2026-Myongji-Trash-Robot/BLDC_ECU/HW/BLDC_Driver/BLDC_Driver_V1.0_schematic.pdf

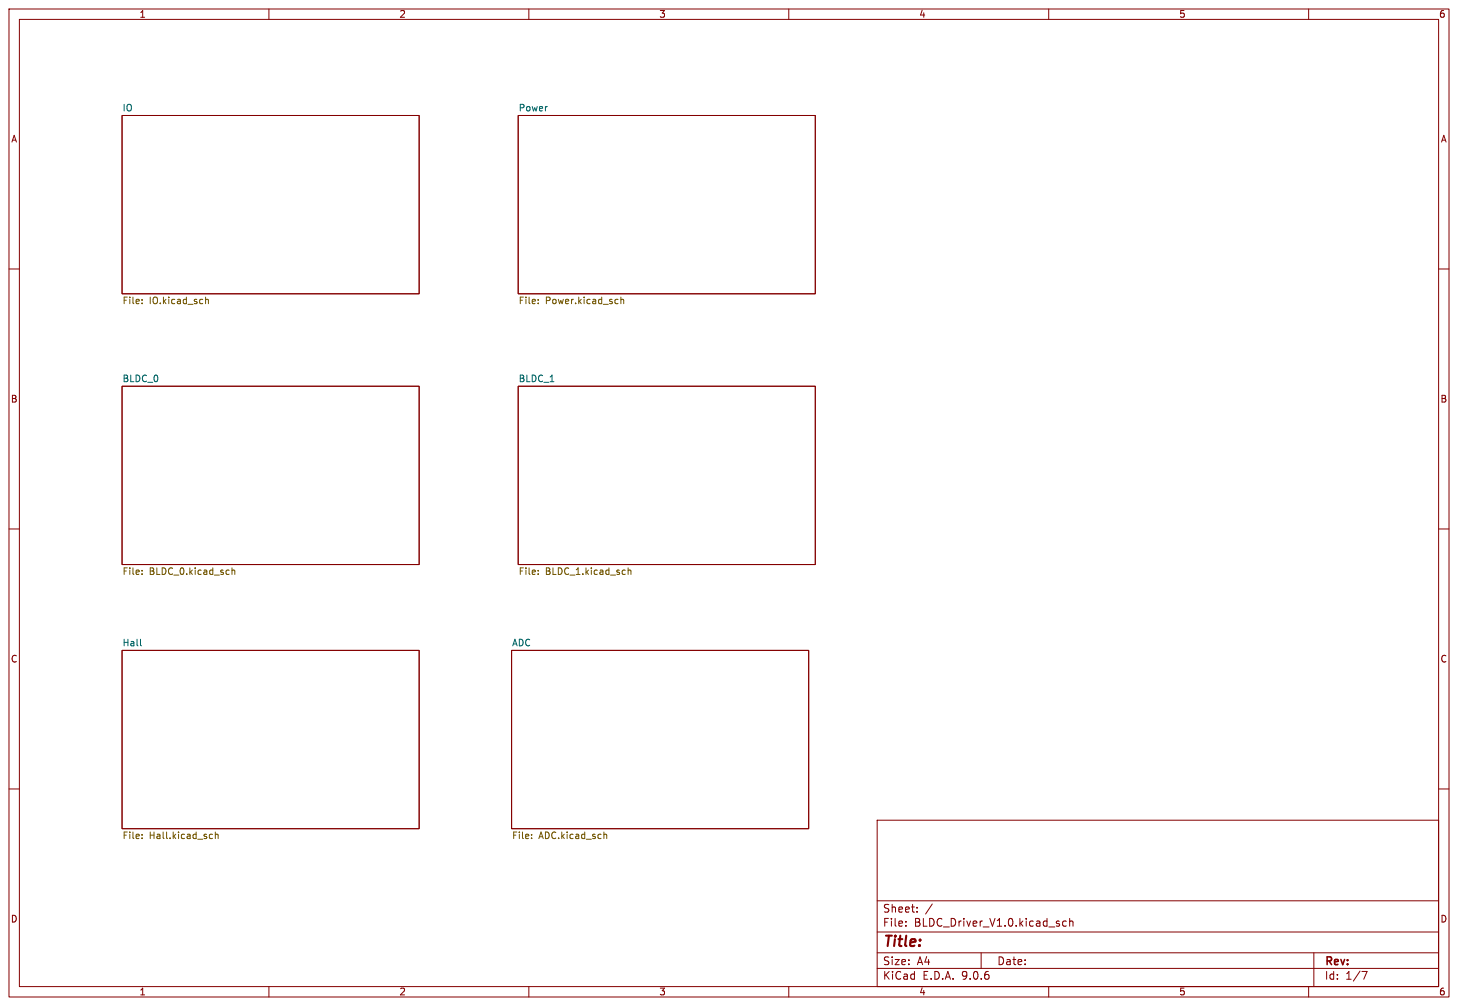
[picture p5: page 1]

Power File: Power.kicad_sch ADC

BLDC_0 File: BLDC_0.kicad_sch Hall File: Hall.kicad_sch

Id: 1/7 Title: File: BLDC_Driver_V1.0.kicad_sch Sheet: /

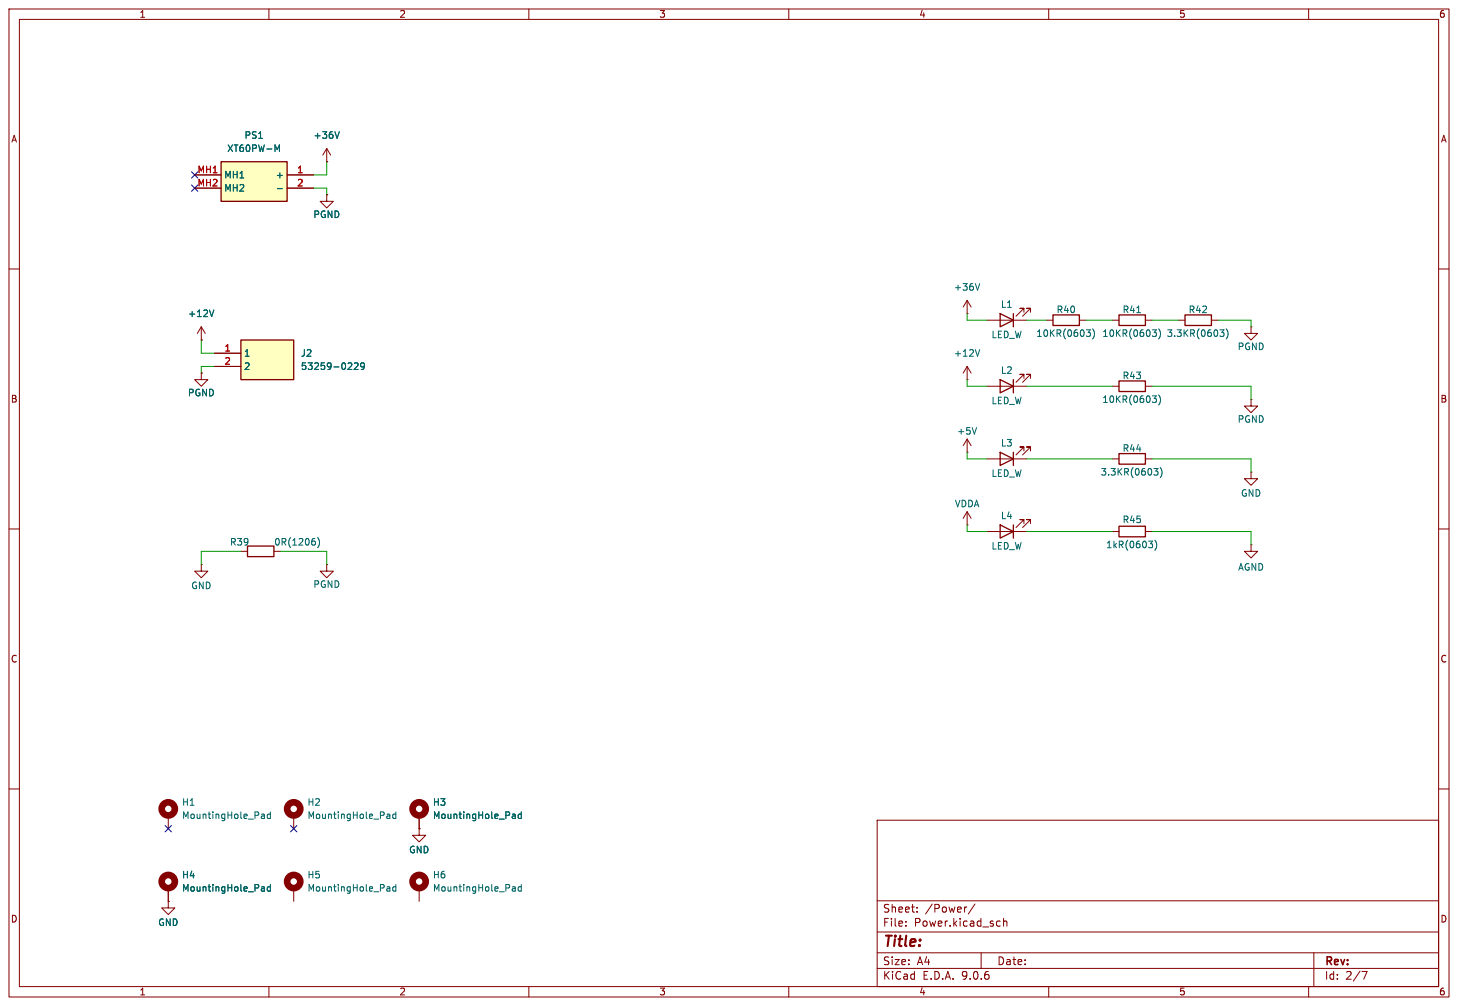
[picture p6: page 2]

Id: 2/7 Title: File: Power.kicad_sch Sheet: /Power/

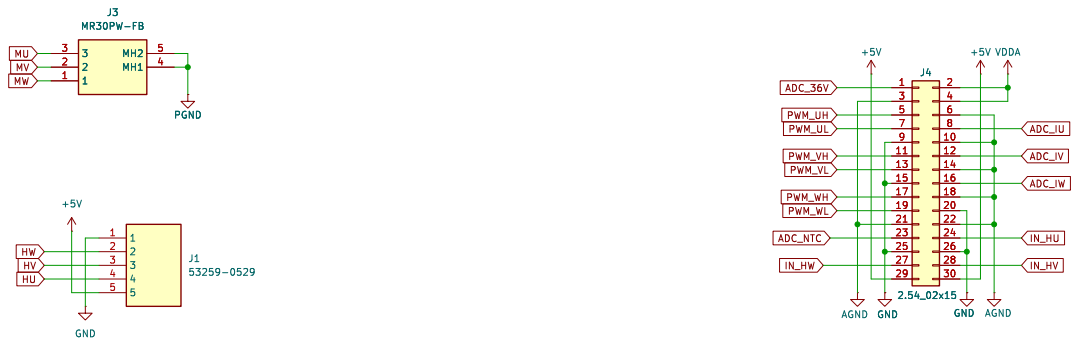
[picture p7: page 3]

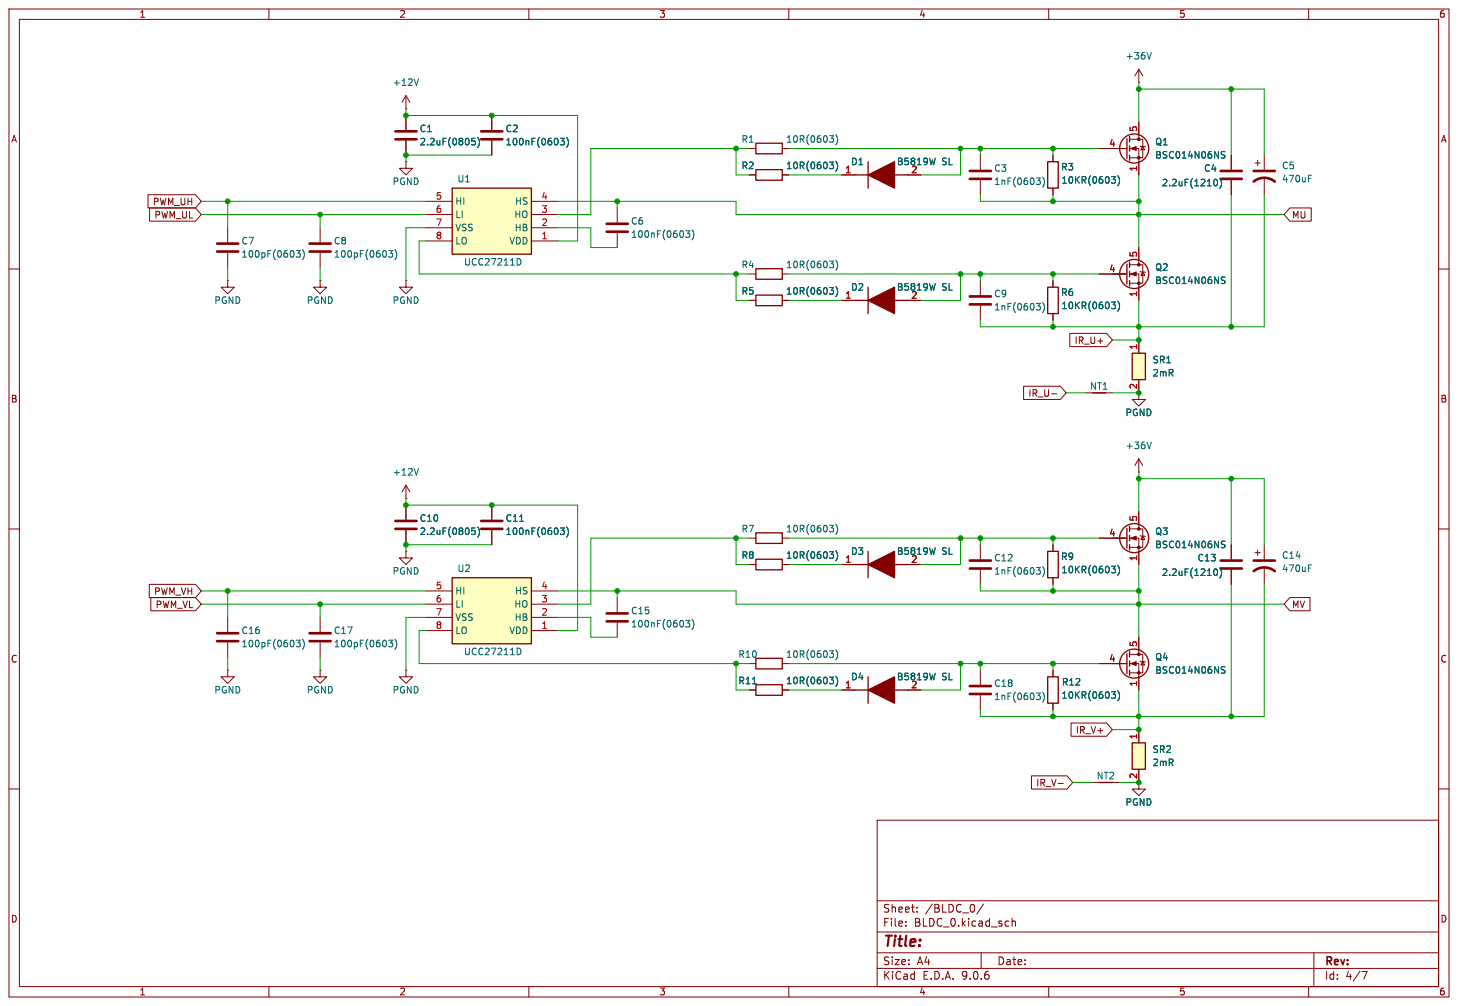
[picture p8: page 4]

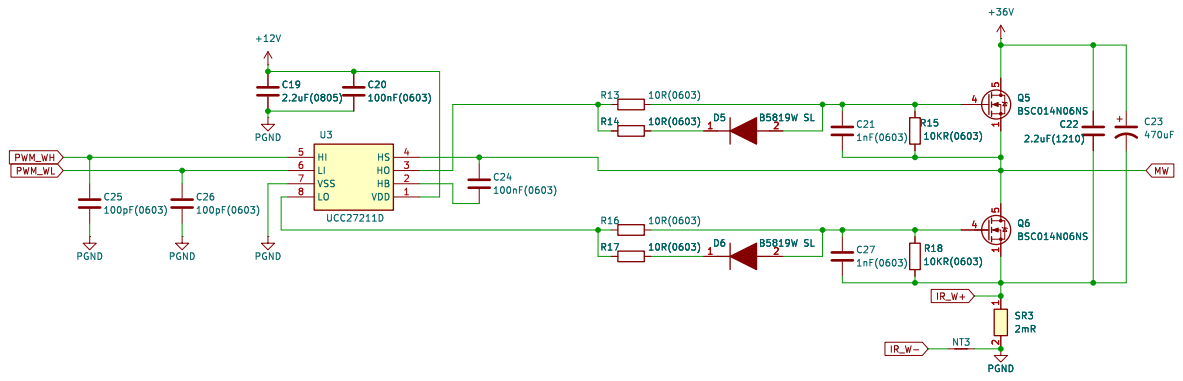
[picture p9: page 5]

Id: 5/7 Title: File: BLDC_1.kicad_sch Sheet: /BLDC_1/

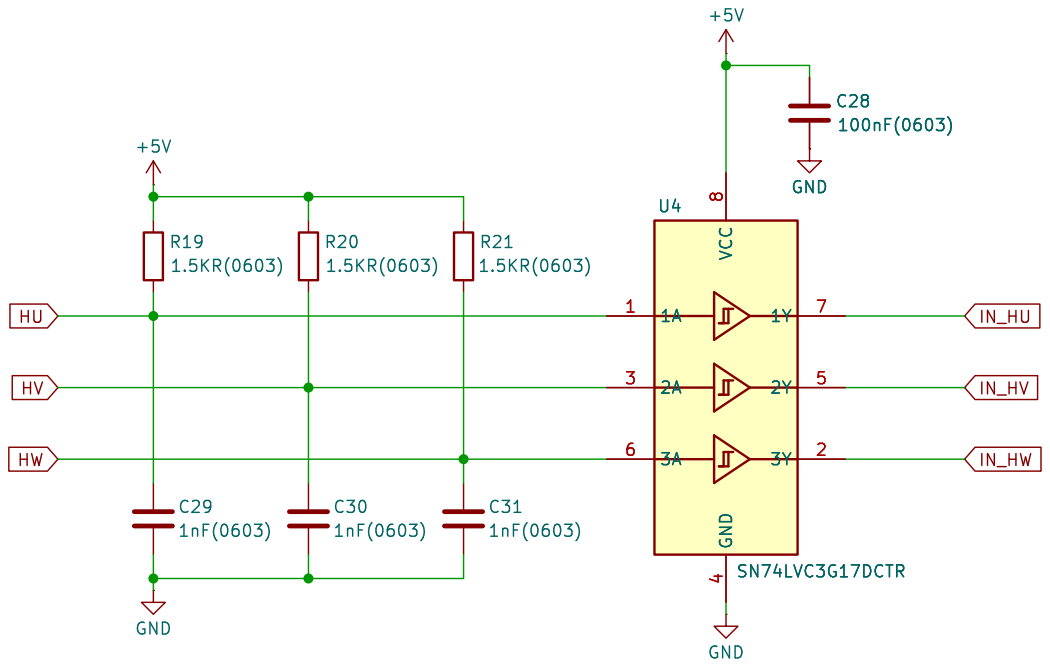
[picture p10: page 6]

Id: 6/7 Title: File: Hall.kicad_sch Sheet: /Hall/

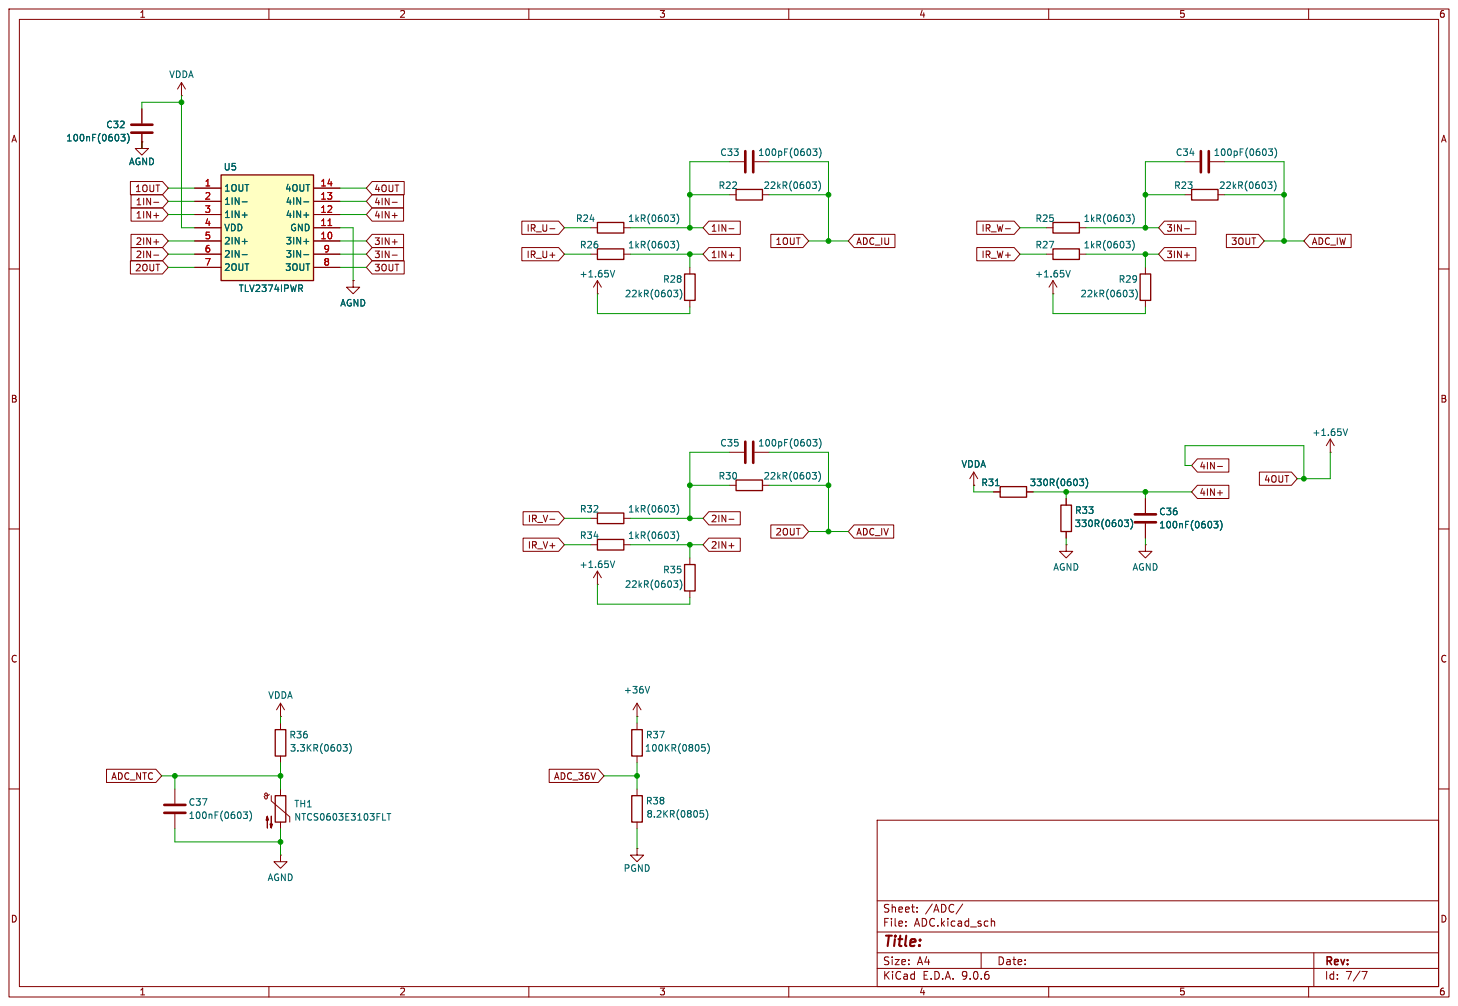
[picture p11: page 7]

Id: 7/7 Title: File: ADC.kicad_sch Sheet: /ADC/
