2026-Myongji-Trash-Robot/BLDC_ECU/HW/BLDC_ECU/BLDC_ECU_V2.0_schematic.pdf

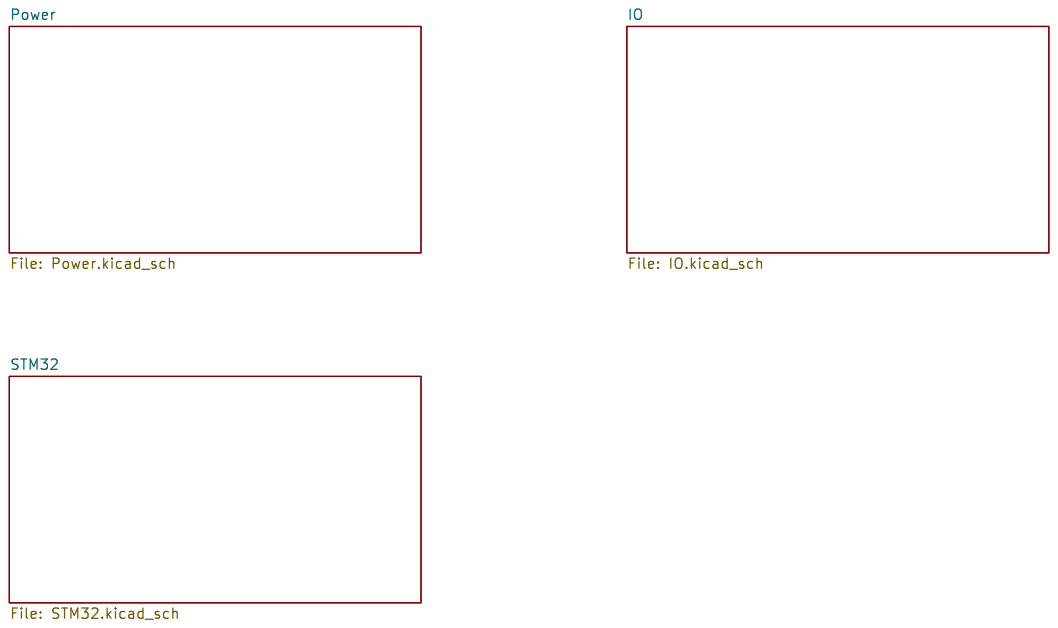
[picture p12: page 1]

Id: 1/4 Title: File: BLDC_ECU_V2.0.kicad_sch Sheet: /

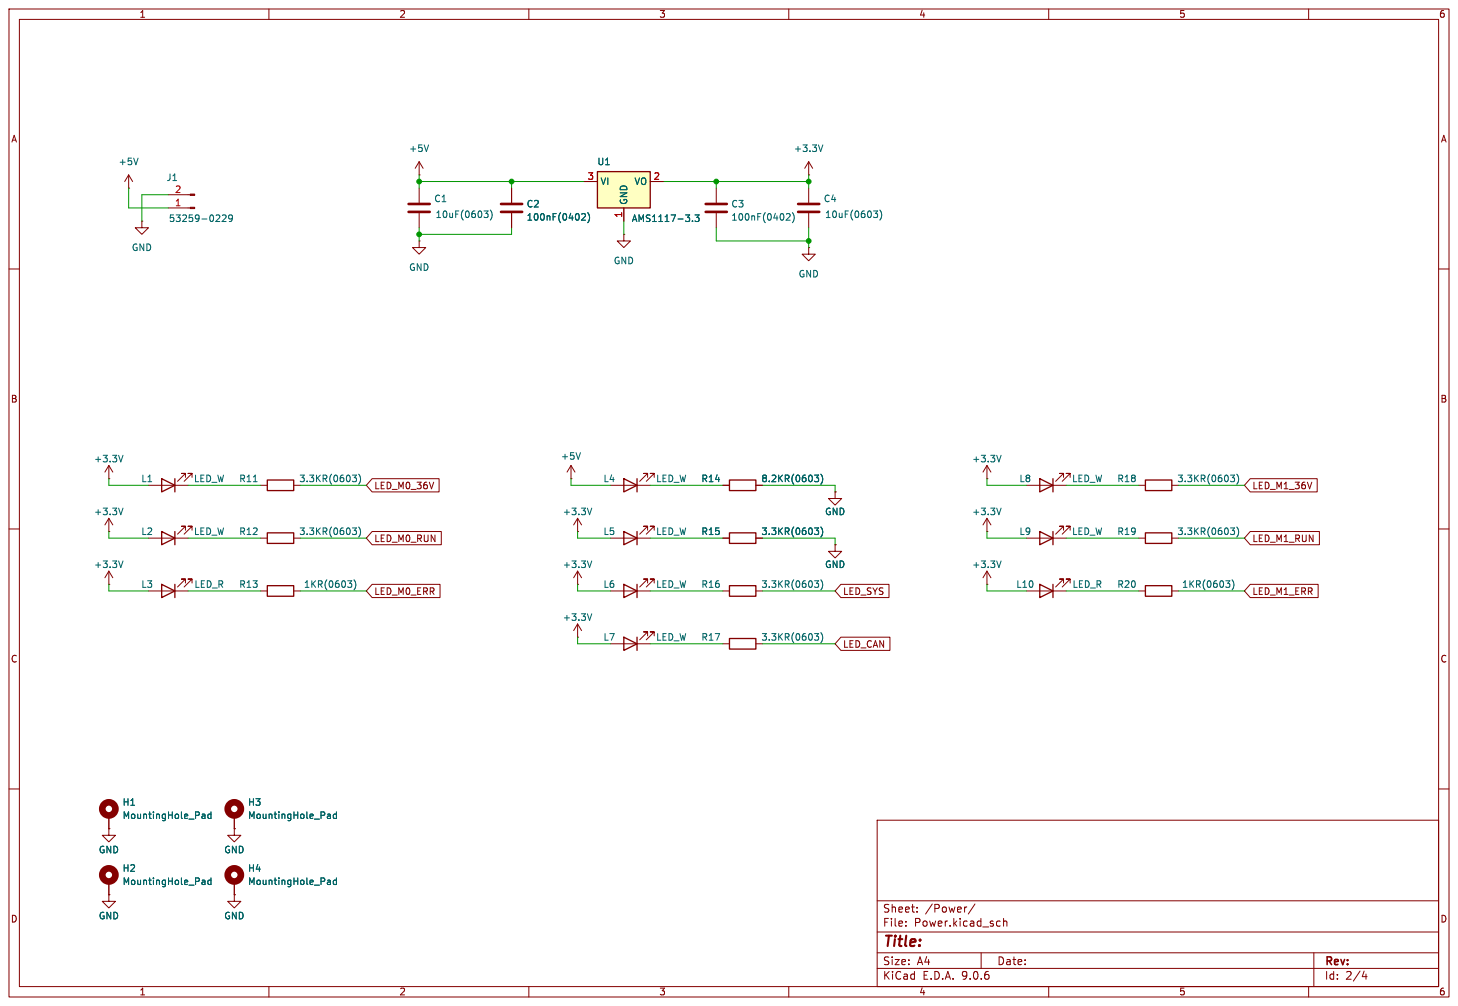
[picture p13: page 2]

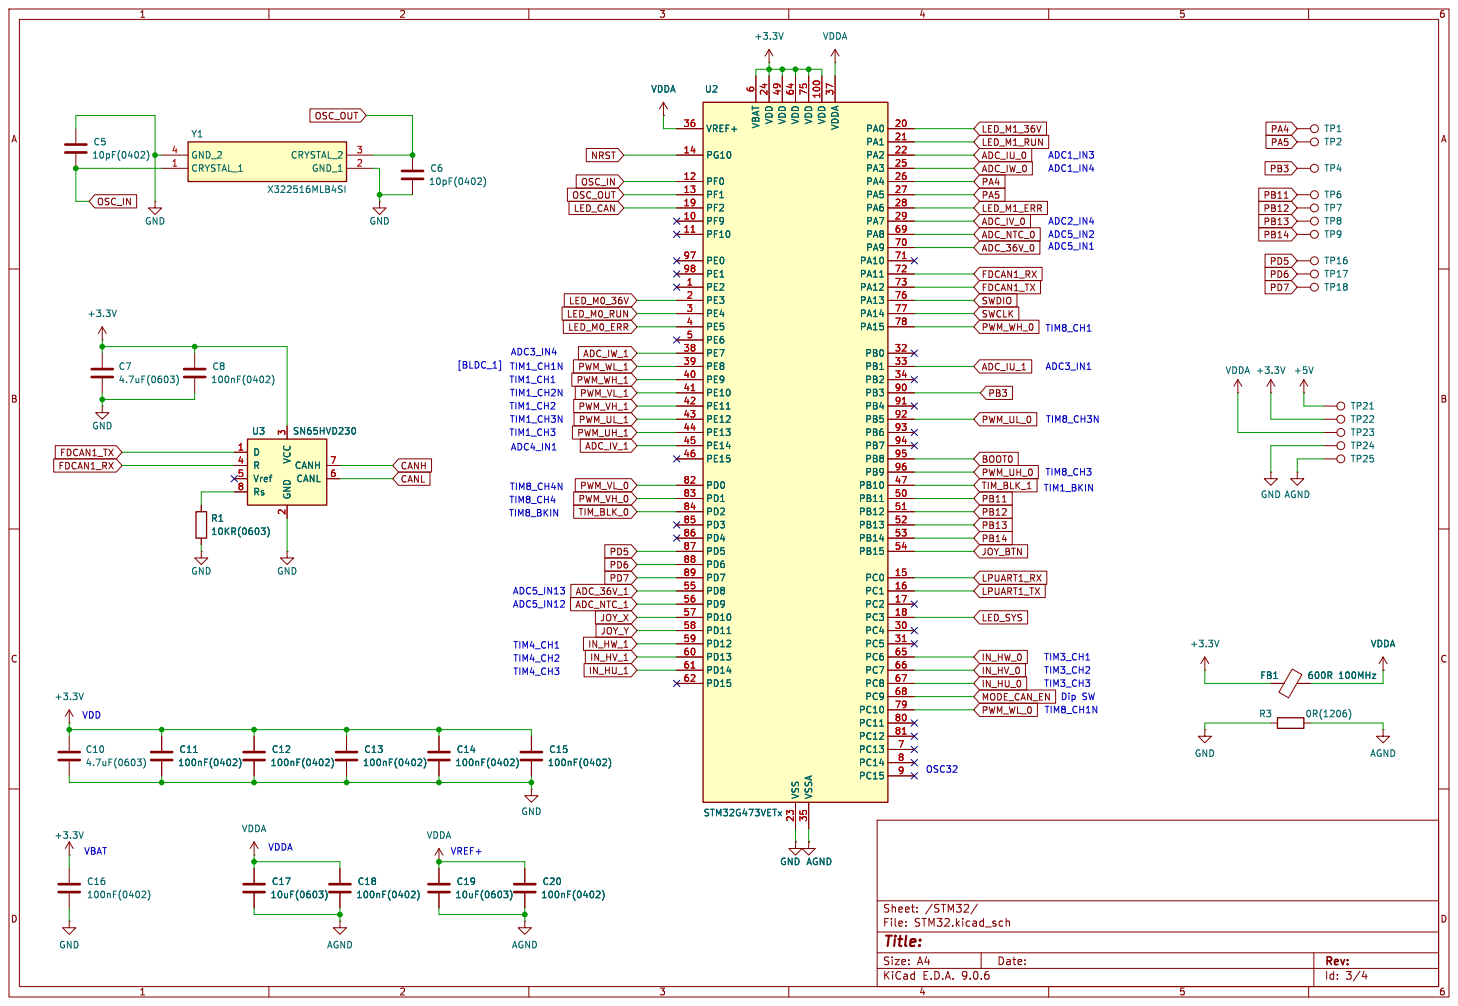
[picture p14: page 3]

6 VDD 24 VDD 49 VDD 64 VSS 23 VDD 75 VSSA 35 VDD 100 VDDA 37 PA0 20 PA1 21 PA2 22 PA3 25 PA4 26 PA5 27 PA6 28 PA7 29 PA8 69 PA9 70 PA10 71 PA11 72 PA12 73 PA13 76 PA14 77 PA15 78 PB0 32 PB1 33 PB2 34 PB3 90 PB4 91 PB5 92 PB6 93 PB7 94 PB8 95 PB9 96 PB10 47 PB11 50 PB12 51 PB13 52 PB14 53 PB15 54 PC0 15 PC1 16 PC2 17 PC3 18 PC4 30 PC5 31 PC6 65 PC7 66 PC8 67 PC9 68 PC10 79 PC11 80 PC12 81 PC13 7 PC14 8 PC15 9 C14

6 VDD 24 VDD 49 VDD 64 VSS 23 VDD 75 VSSA 35 VDD 100 VDDA 37 PA0 20 PA1 21 PA2 22 PA3 25 PA4 26 PA5 27 PA6 28 PA7 29 PA8 69 PA9 70 PA10 71 PA11 72 PA12 73 PA13 76 PA14 77 PA15 78 PB0 32 PB1 33 PB2 34 PB3 90 PB4 91 PB5 92 PB6 93 PB7 94 PB8 95 PB9 96 PB10 47 PB11 50 PB12 51 PB13 52 PB14 53 PB15 54 PC0 15 PC1 16 PC2 17 PC3 18 PC4 30 PC5 31 PC6 65 PC7 66 PC8 67 PC9 68 PC10 79 PC11 80 PC12 81 PC13 7 PC14 8 PC15 9
[BLDC_1] VDDA

Id: 3/4 Title: File: STM32.kicad_sch Sheet: /STM32/

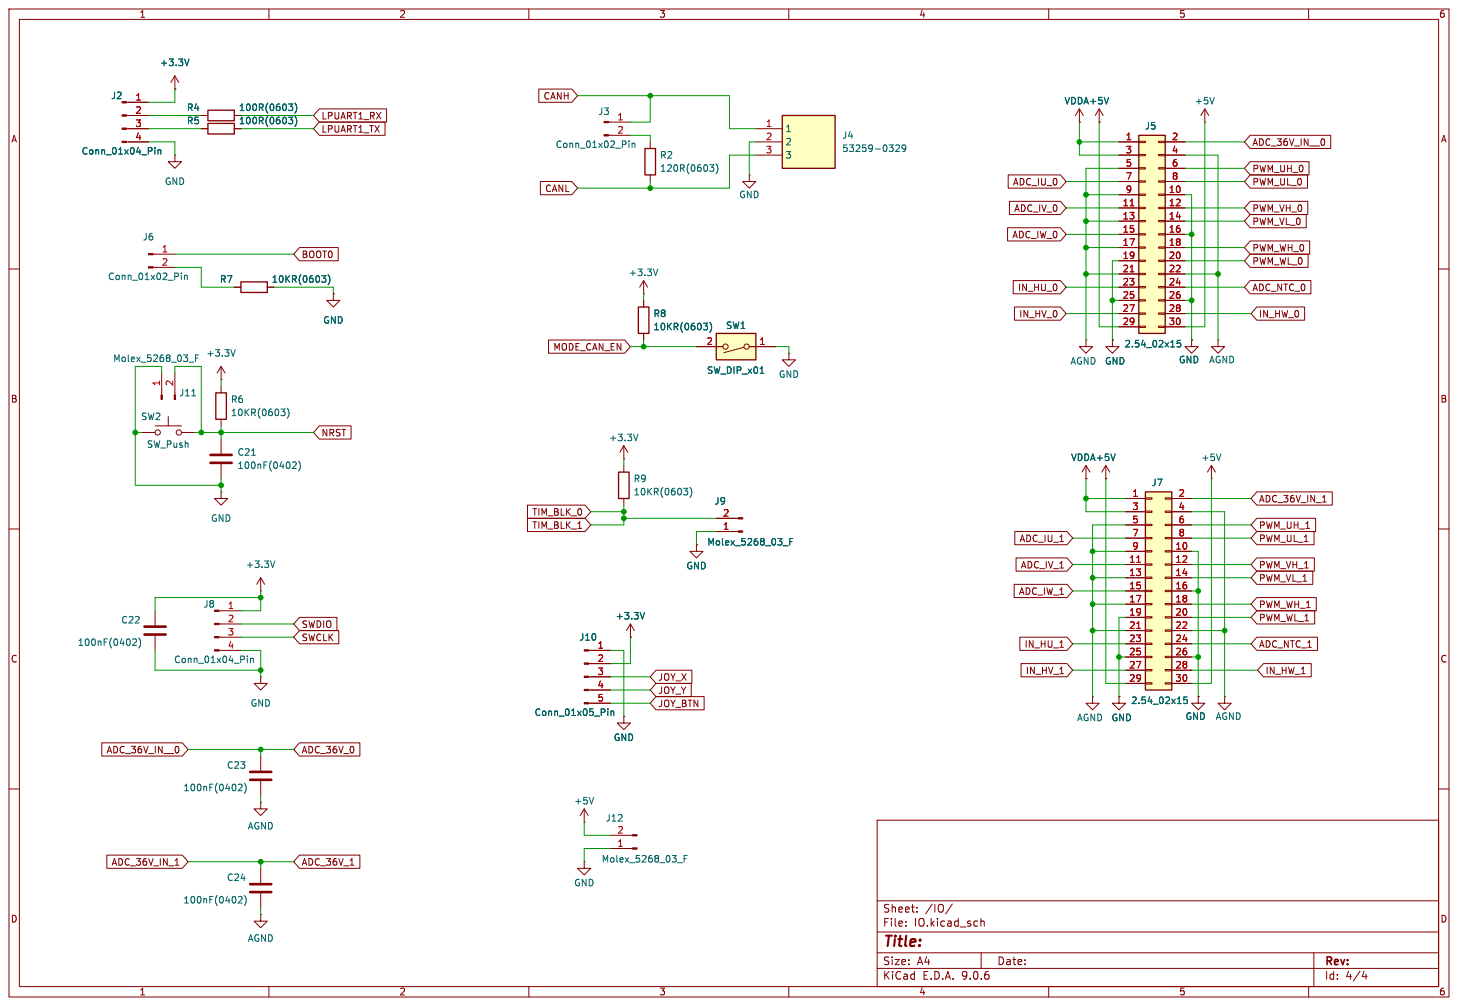
[picture p15: page 4]

Id: 4/4 Title: File: IO.kicad_sch Sheet: /IO/
