2026-Myongji-Trash-Robot/BLDC_ECU/HW/BLDC_Driver/BLDC_Driver_V1.0_PCB.pdf

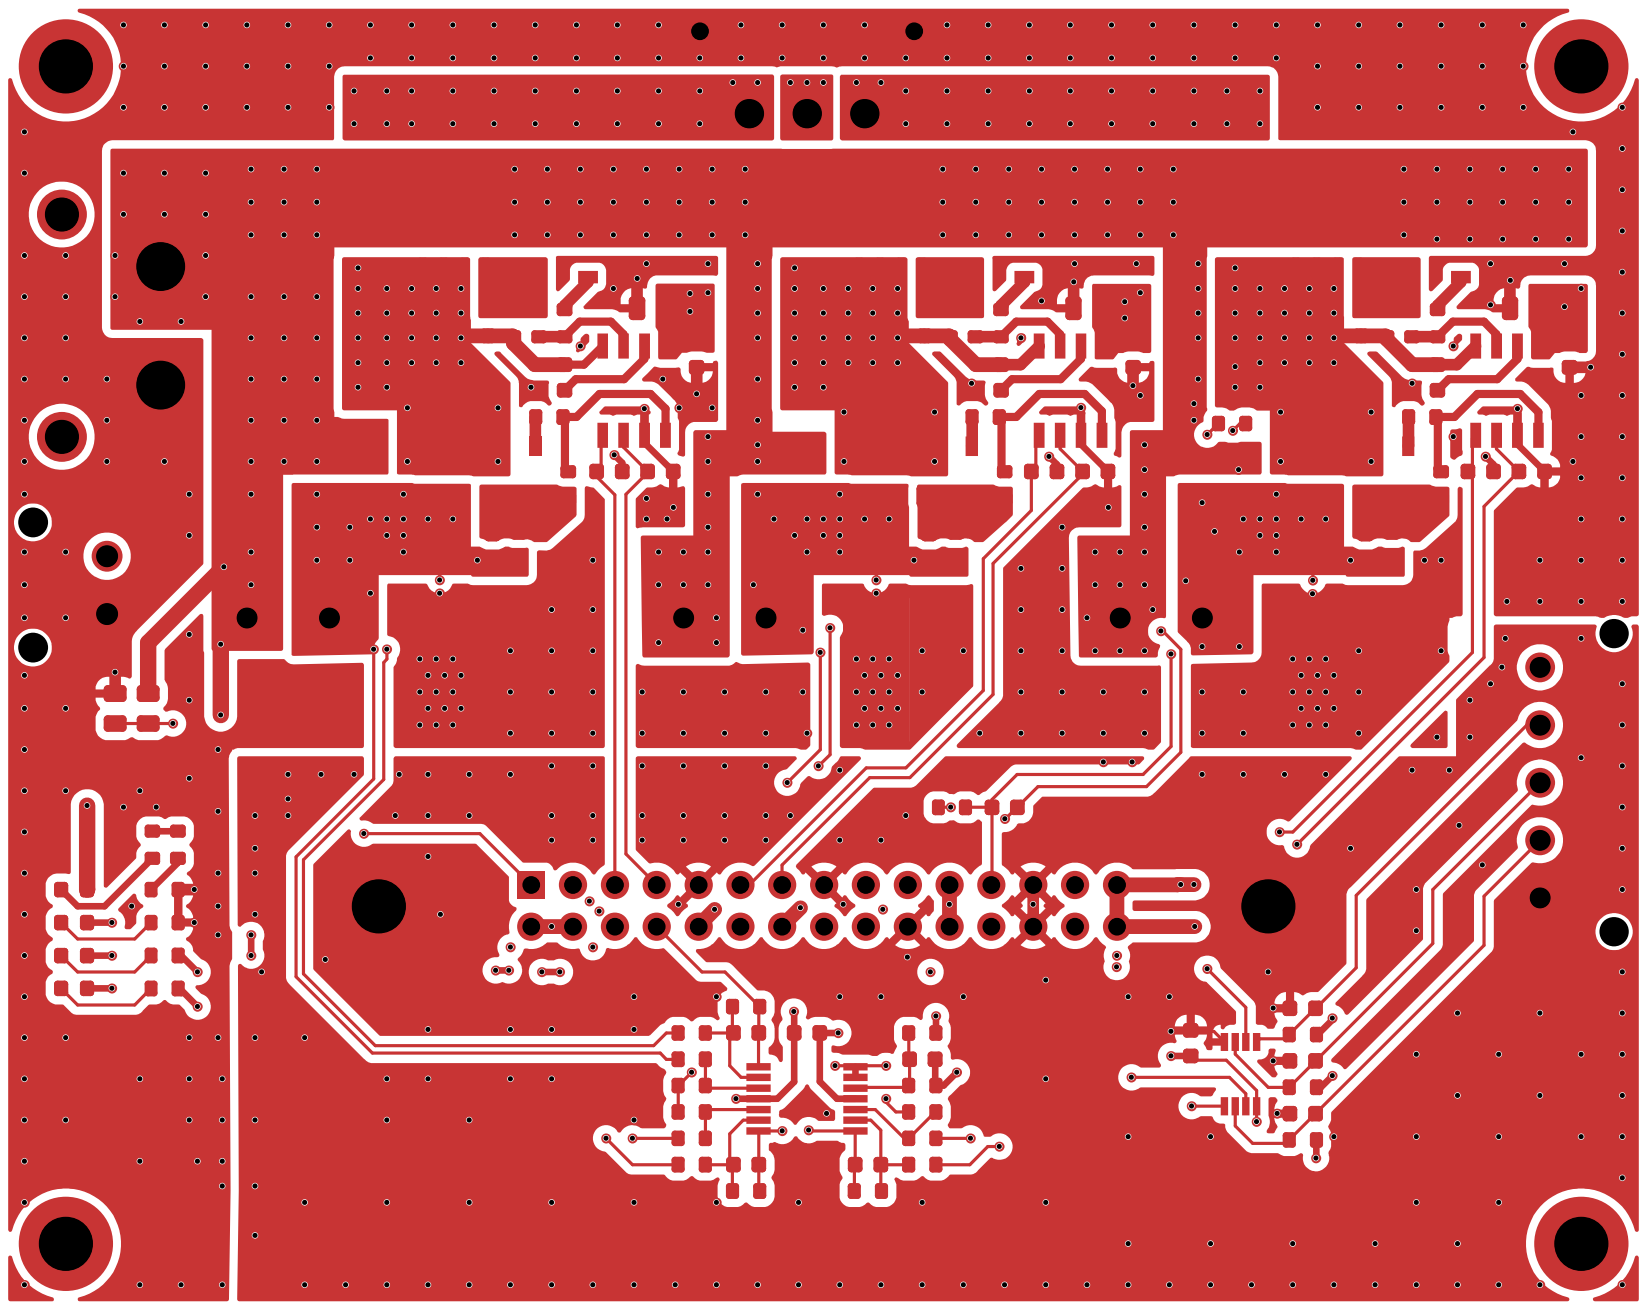
[picture p16: page 1]

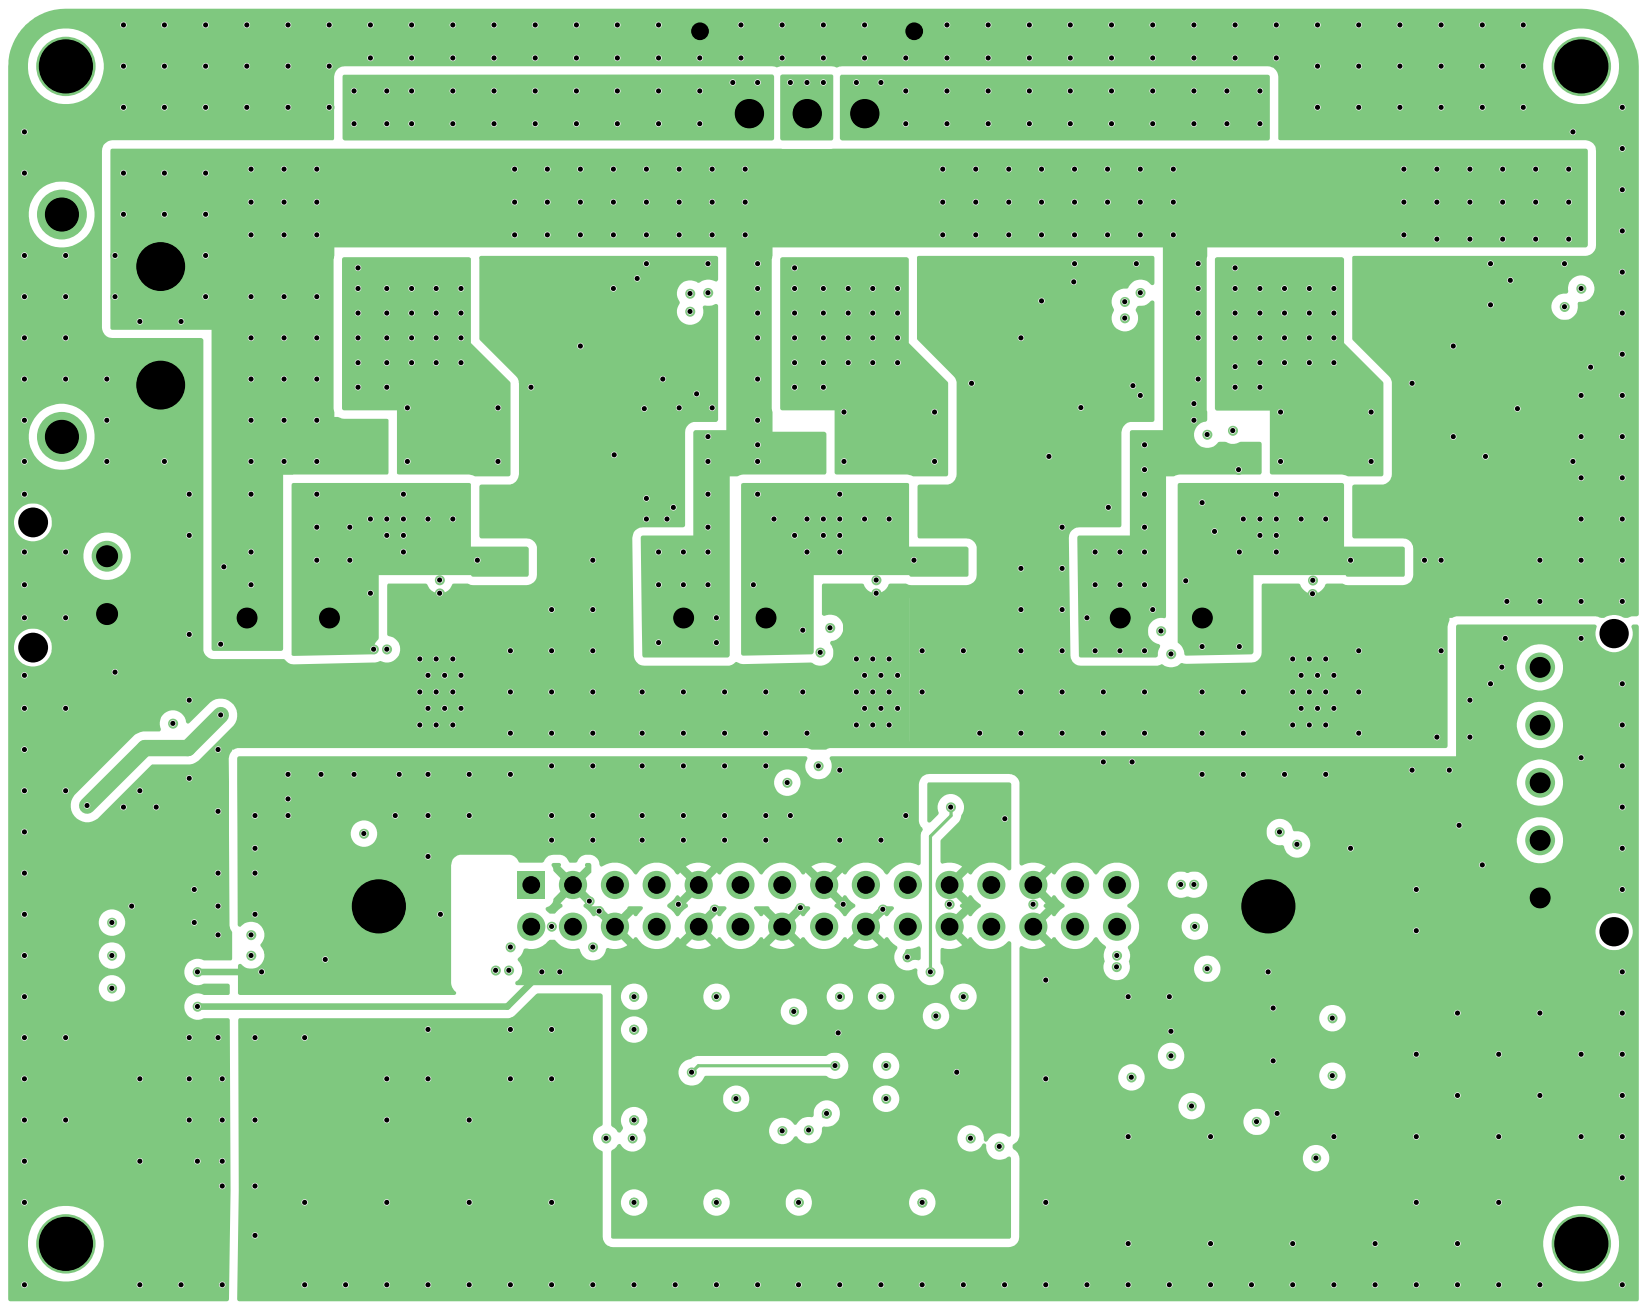
[picture p17: page 2]

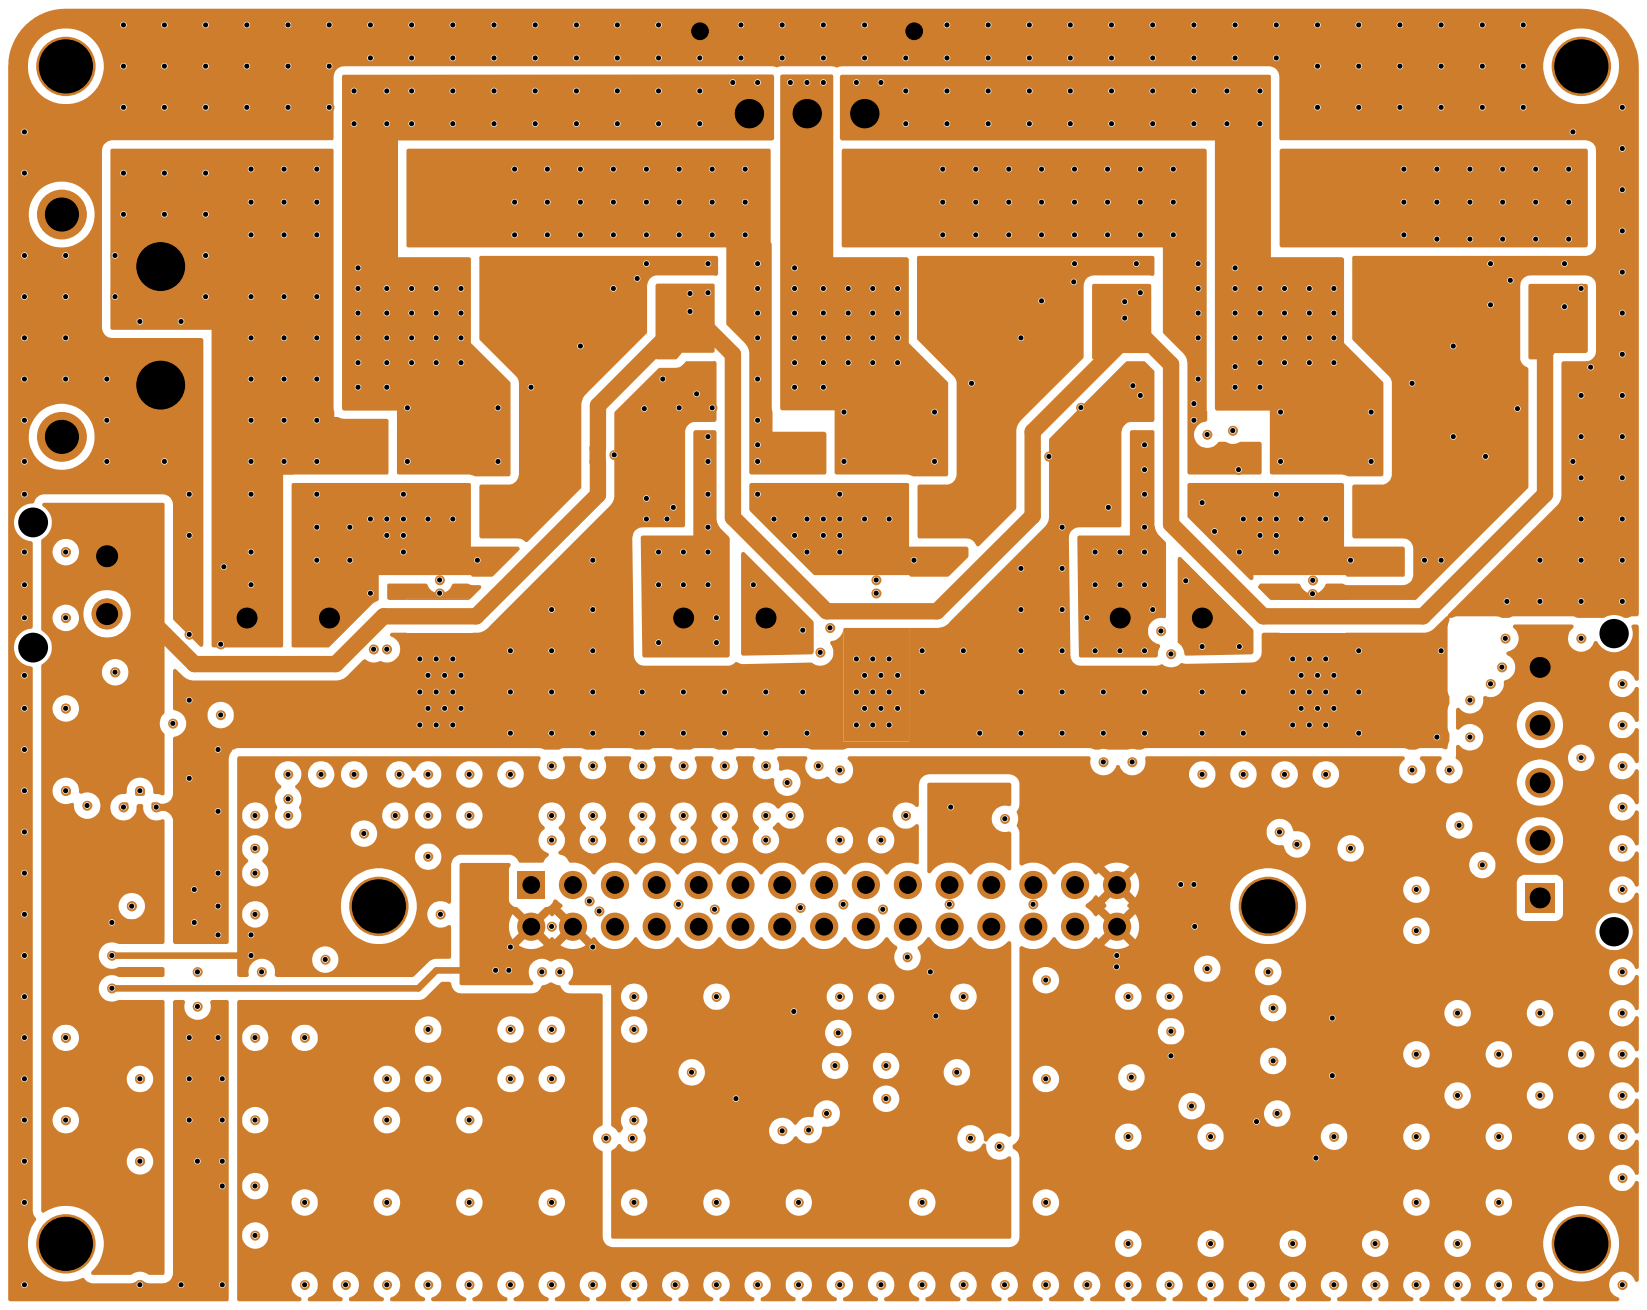
[picture p18: page 3]

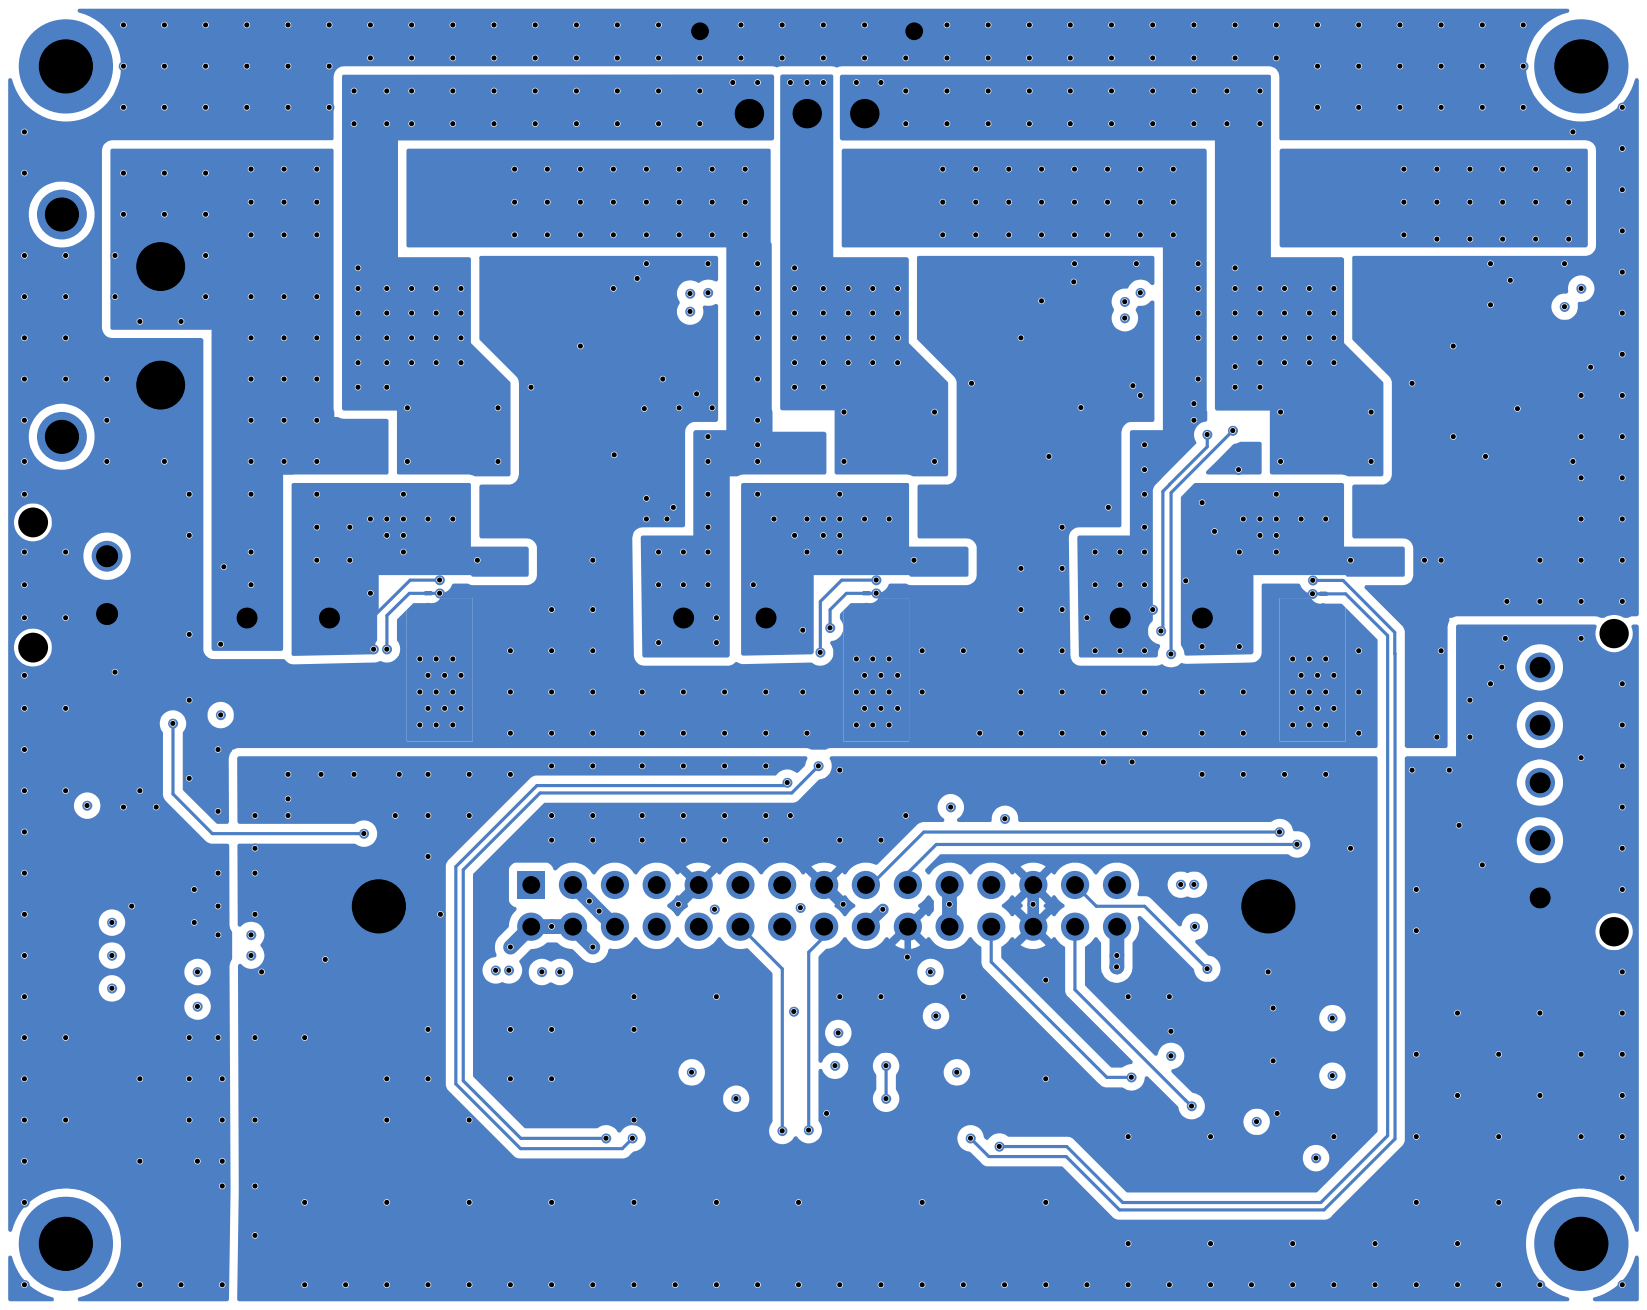
[picture p19: page 4]
