2026-Myongji-Trash-Robot/BLDC_ECU/HW/BLDC_ECU/BLDC_ECU_V2.0_PCB.pdf

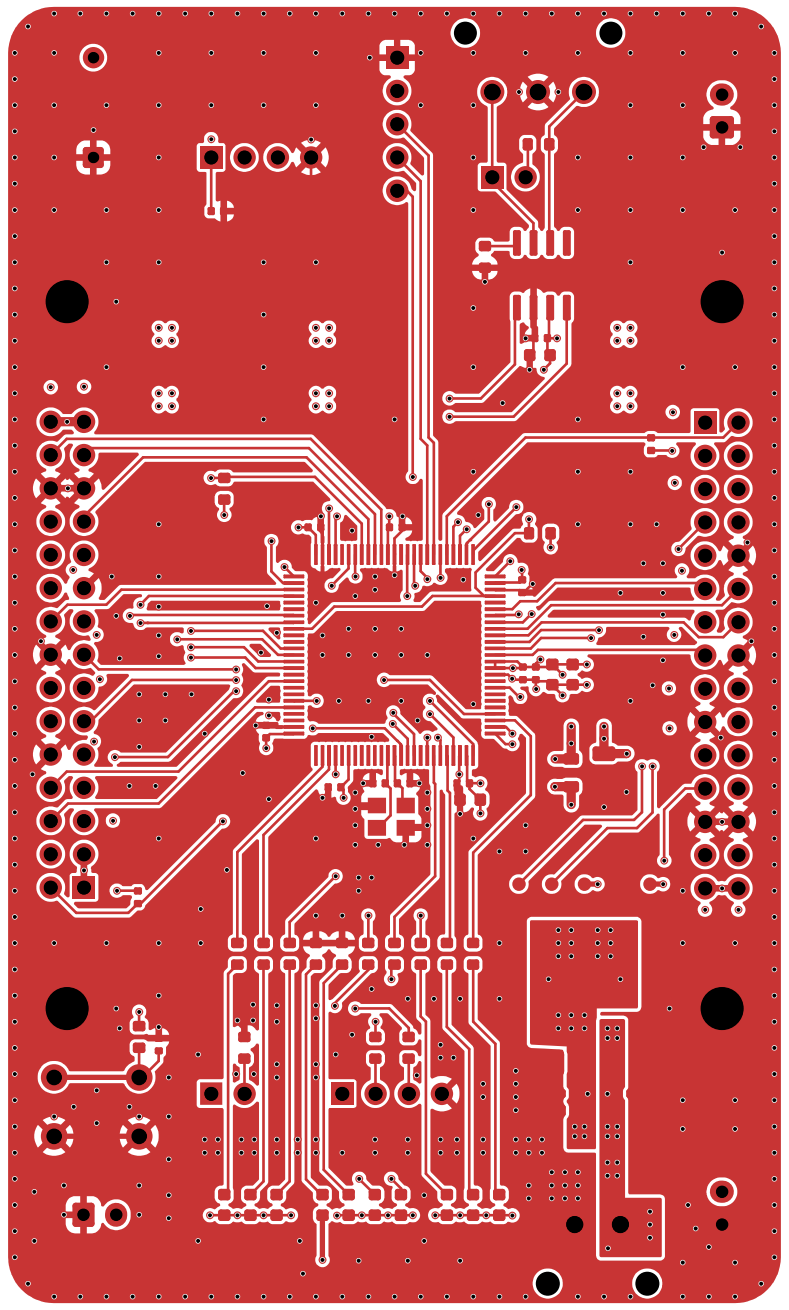
[picture p20: page 1]

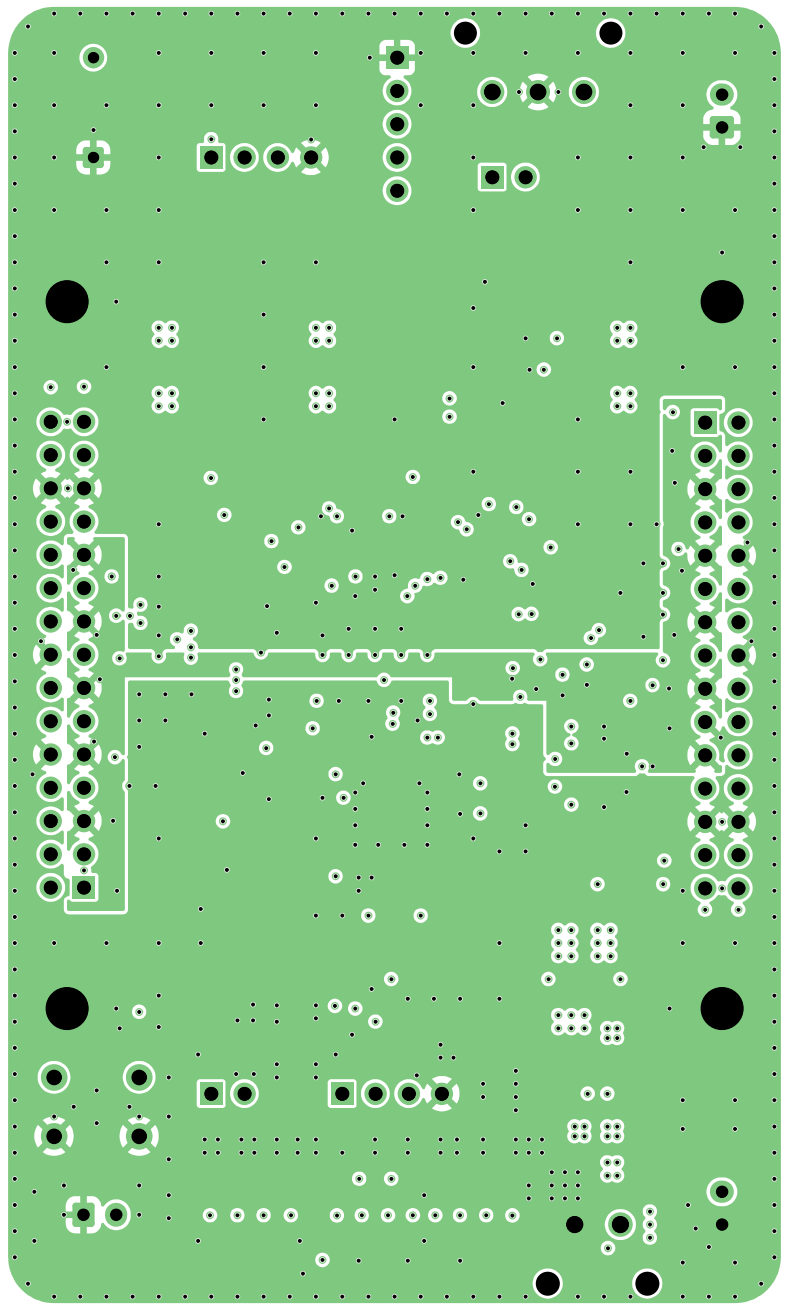
[picture p21: page 2]

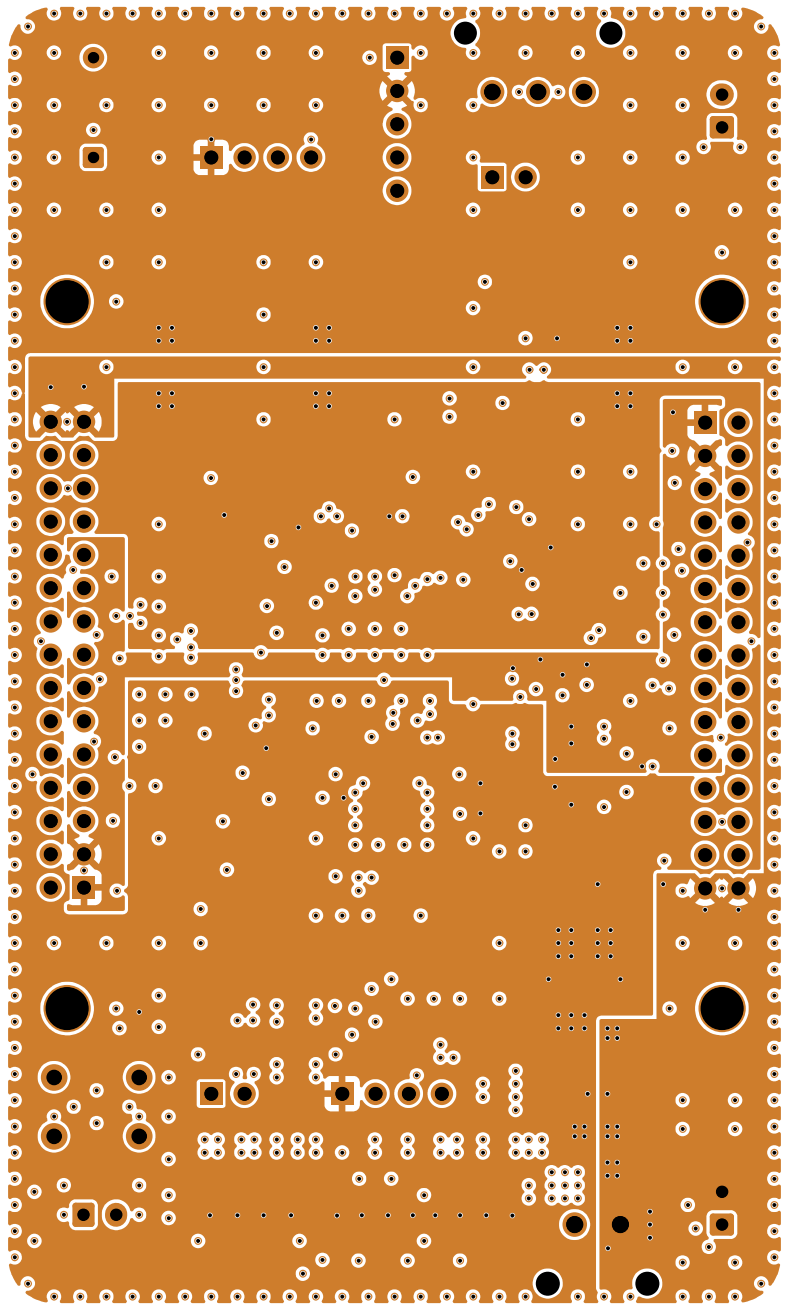
[picture p22: page 3]

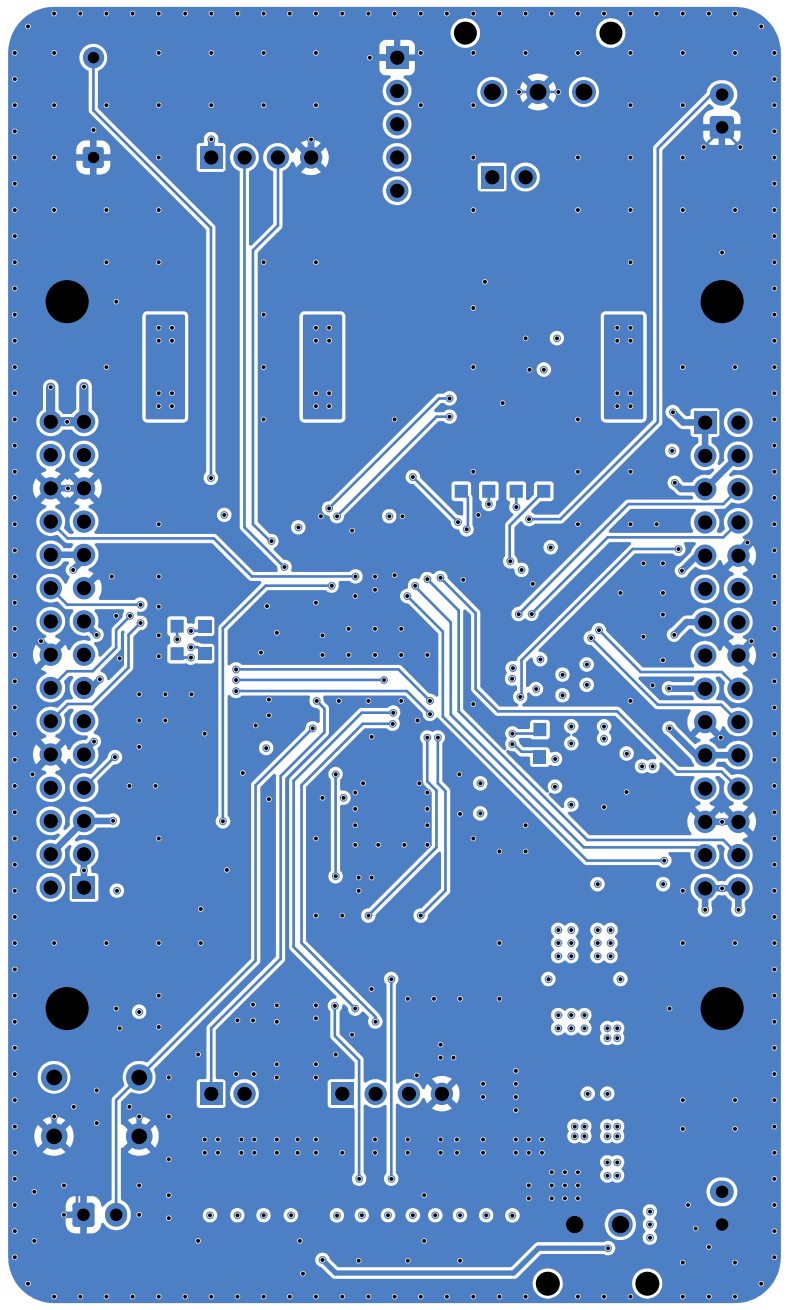
[picture p23: page 4]
