2026-Myongji-Trash-Robot/BLDC_ECU/FW/BLDC_FW_V0.0.1/BLDC_FW_V0.0.1.ioc

Mcu.UserName=STM32G473VETx
PA0.GPIO_Label=M1_LED_36V
PA0.Signal=GPIO_Output
PA1.GPIO_Label=M1_LED_RUN
PA1.Signal=GPIO_Output
PA11.Signal=FDCAN1_RX
PA12.Signal=FDCAN1_TX
PA13.Signal=SYS_JTMS-SWDIO
PA14.Signal=SYS_JTCK-SWCLK
PA15.GPIO_Label=M0_WH_T81
PA15.Signal=S_TIM8_CH1
PA2.GPIO_Label=M0_IU_A13
PA2.Signal=ADC1_IN3
PA3.GPIO_Label=M0_IW_A14
PA3.Signal=ADC1_IN4
PA6.GPIO_Label=M1_LED_ERR
PA6.Signal=GPIO_Output
PA7.GPIO_Label=M0_IV_A24
PA7.Signal=ADC2_IN4
PA8.GPIO_Label=M0_NTC_A51
PA8.Signal=ADC5_IN1
PA9.GPIO_Label=M0_36V_A52
PA9.Signal=ADC5_IN2
PB1.GPIO_Label=M1_IU_A31
PB1.Signal=ADC3_IN1
PB10.GPIO_Label=M1_BRK_T1B
PB10.Signal=TIM1_BKIN
PB15.GPIO_Label=JOY_BTN
PB15.Signal=GPIO_Input
PB5.GPIO_Label=M0_UL_T83N
PB5.Signal=TIM8_CH3N
PB9.GPIO_Label=M0_UH_T83
PB9.Signal=S_TIM8_CH3
PC0.Signal=LPUART1_RX
PC1.Signal=LPUART1_TX
PC10.GPIO_Label=M0_WL_T81N
PC10.Signal=TIM8_CH1N
PC3.GPIO_Label=CORE_LED_SYS
PC3.Signal=GPIO_Output
PC6.GPIO_Label=M0_HW_T31
PC6.Signal=S_TIM3_CH1
PC7.GPIO_Label=M0_HV_T32
PC7.Signal=S_TIM3_CH2
PC8.GPIO_Label=M0_HU_T33
PC8.Signal=S_TIM3_CH3
PC9.GPIO_Label=MODE_CAN_EN
PC9.Signal=GPIO_Input
PD0.GPIO_Label=M0_VL_T84N
PD0.Signal=TIM8_CH4N
PD1.GPIO_Label=M0_VH_T84
PD1.Signal=S_TIM8_CH4
PD10.GPIO_Label=JOY_X_A57
PD10.Signal=ADC5_IN7
PD11.GPIO_Label=JOY_Y_A58
PD11.Signal=ADC5_IN8
PD12.GPIO_Label=M1_HW_T41
PD12.Signal=S_TIM4_CH1
PD13.GPIO_Label=M1_HV_T42
PD13.Signal=S_TIM4_CH2
PD14.GPIO_Label=M1_HU_T43
PD14.Signal=S_TIM4_CH3
PD2.GPIO_Label=M0_BRK_T8B
PD2.Signal=TIM8_BKIN
PD8.GPIO_Label=M1_36V_A512
PD8.Signal=ADC5_IN12
PD9.GPIO_Label=M1_NTC_A513
PD9.Signal=ADC5_IN13
PE10.GPIO_Label=M1_VL_T12N
PE10.Signal=TIM1_CH2N
PE11.GPIO_Label=M1_VH_T12
PE11.Signal=S_TIM1_CH2
PE12.GPIO_Label=M1_UL_T13N
PE12.Signal=TIM1_CH3N
PE13.GPIO_Label=M1_UH_T13
PE13.Signal=S_TIM1_CH3
PE14.GPIO_Label=M1_IV_A41
PE14.Signal=ADC4_IN1
PE3.GPIO_Label=M0_LED_36V
PE3.Signal=GPIO_Output
PE4.GPIO_Label=M0_LED_RUN
PE4.Signal=GPIO_Output
PE5.GPIO_Label=M0_LED_ERR
PE5.Signal=GPIO_Output
PE7.GPIO_Label=M1_IW_A34
PE7.Signal=ADC3_IN4
PE8.GPIO_Label=M1_WL_T11N
PE8.Signal=TIM1_CH1N
PE9.GPIO_Label=M1_WH_T11
PE9.Signal=S_TIM1_CH1
PF0-OSC_IN.Signal=RCC_OSC_IN
PF1-OSC_OUT.Signal=RCC_OSC_OUT
PF2.GPIO_Label=CORE_LED_CAN
PF2.Signal=GPIO_Output
