2026-Myongji-Trash-Robot/BLDC_ECU/(notices)

Notices in the files:
FW/BLDC_FW_V0.0.1/Core/Inc/main.h:
Copyright (c) 2026 STMicroelectronics.
All rights reserved.
This software is licensed under terms that can be found in the LICENSE file
